jpnich/Group-Project-Y2/Interface/Final Circuits.pptx

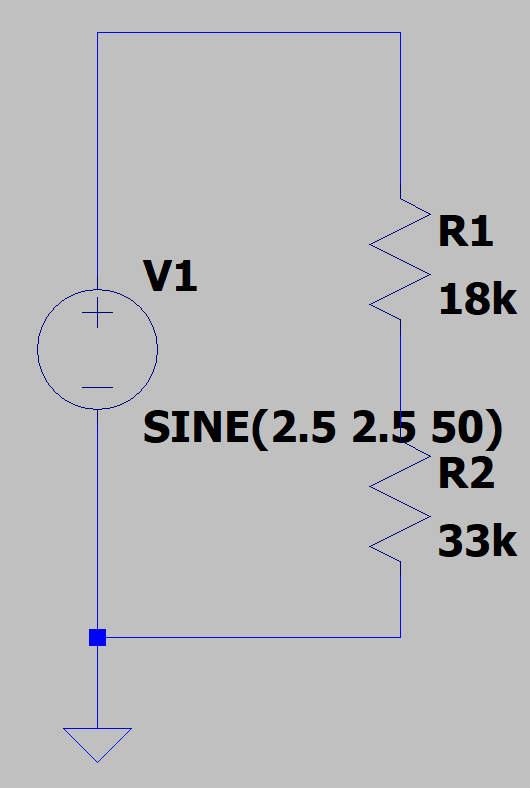
[picture p9: figure]

(a)

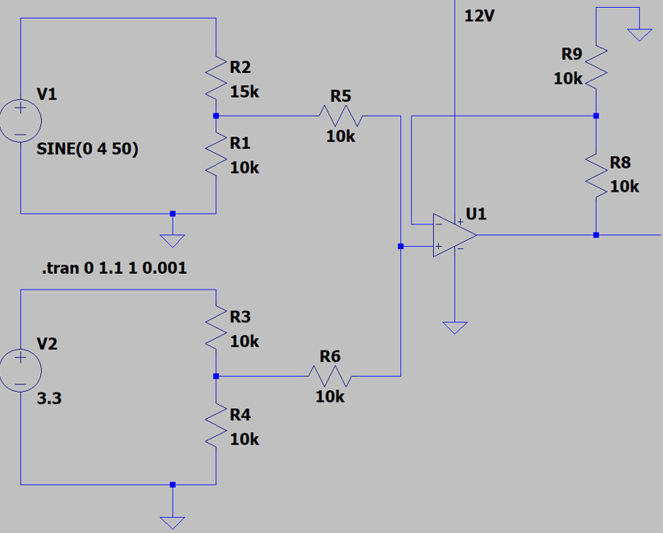
[picture p10: figure]
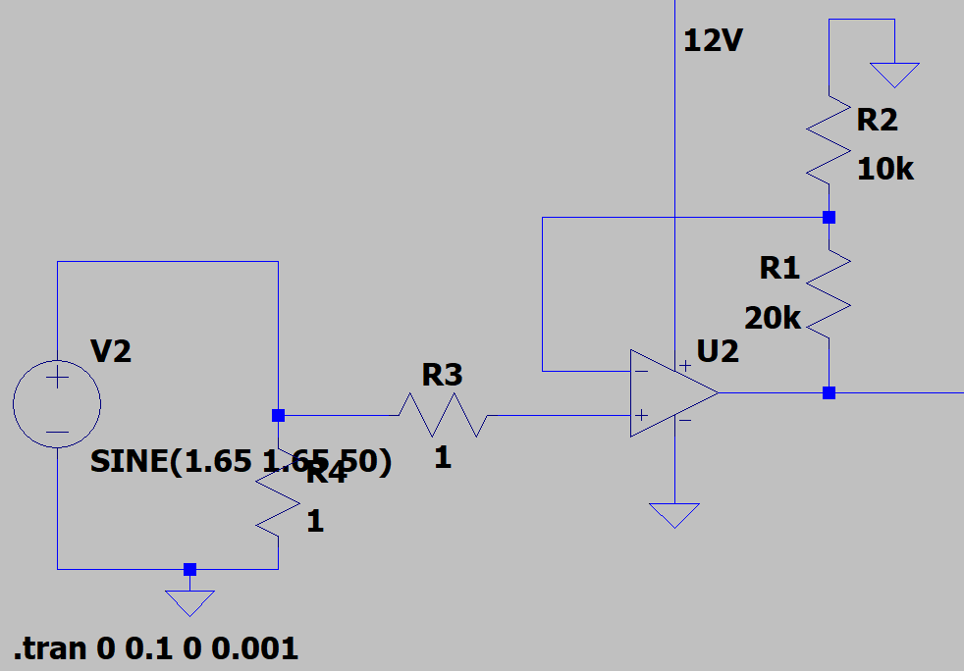
[picture p11: figure]

(c)

(e)

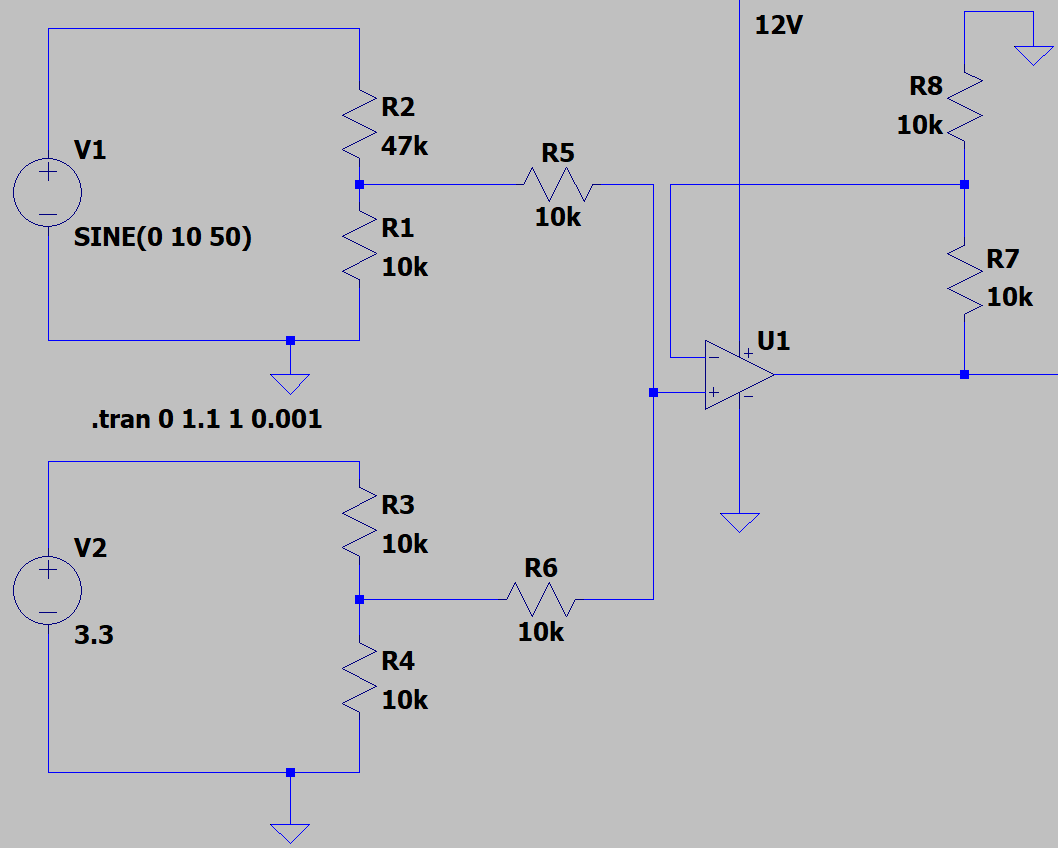
[picture p12: figure]

(b)

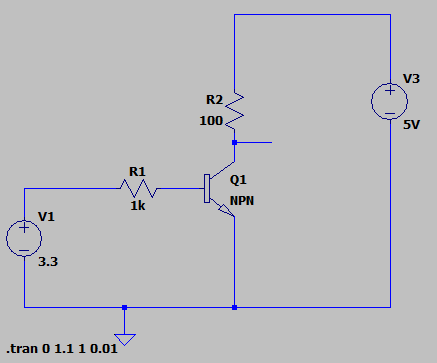
[picture p13: figure]

(d)

(a) Busbar voltage
(b) usbar current
(c) mains capacity
(d) digital inputs
(e) digital outputs
