jpnich/Group-Project-Y2/Interface/drawn_circuitry.pptx

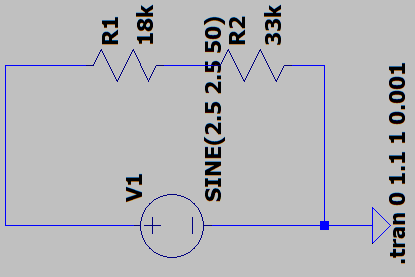
[picture p14: figure]
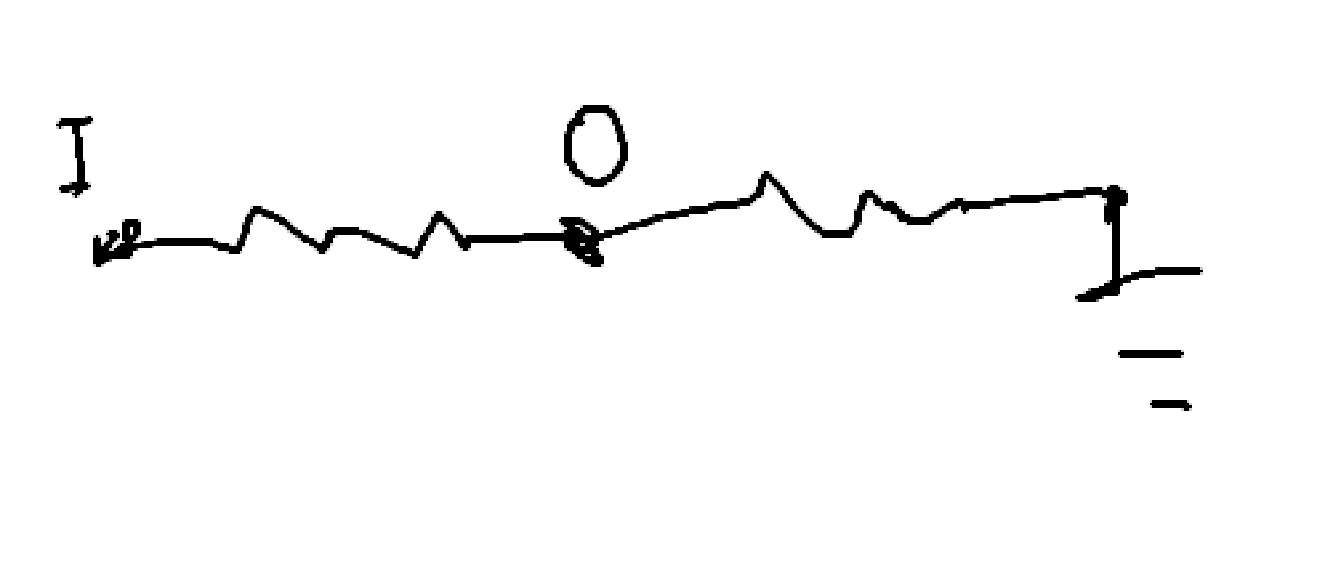
[picture p15: figure]

## Slide 2

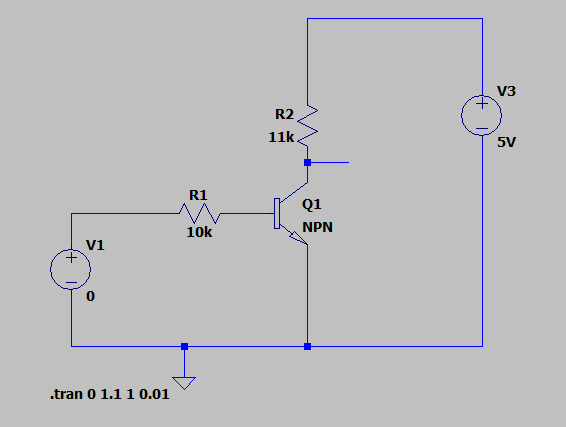
[picture p16: figure]
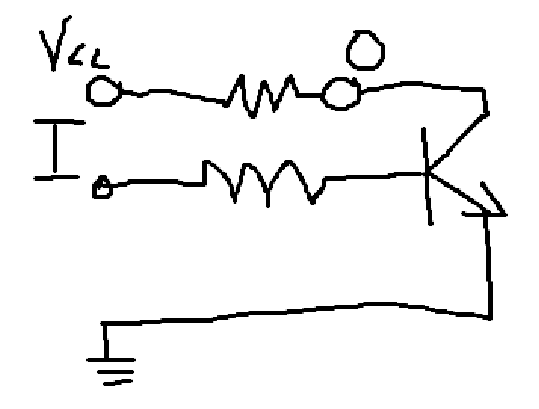
[picture p17: figure]

## Slide 3

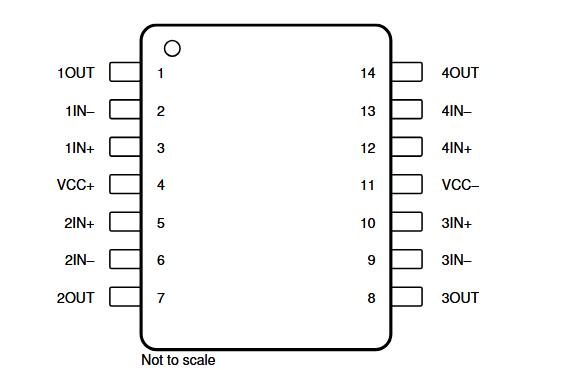
[picture p18: figure]
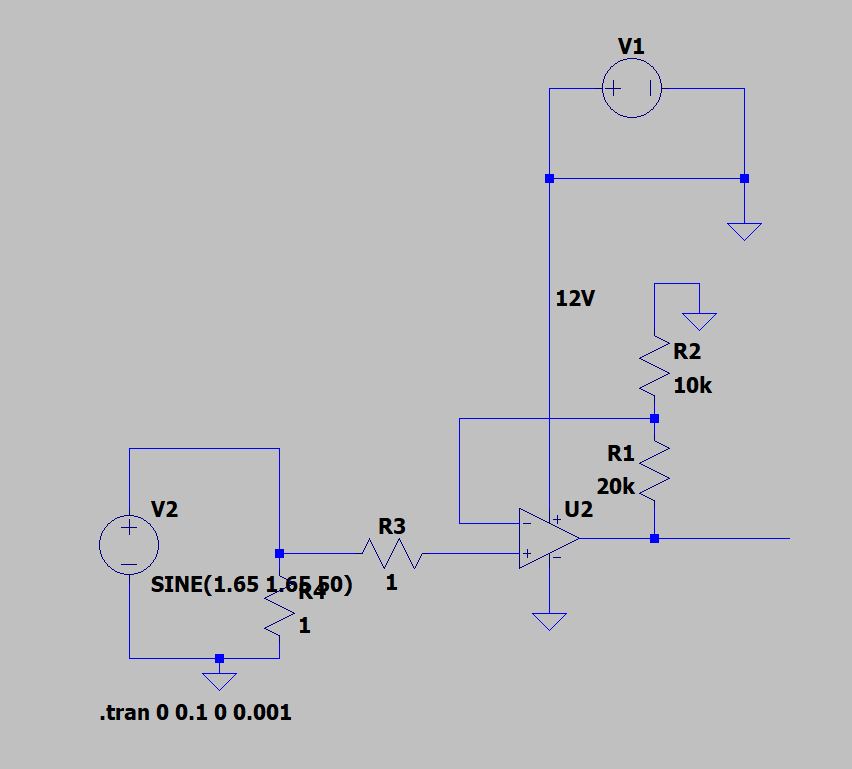
[picture p19: figure]
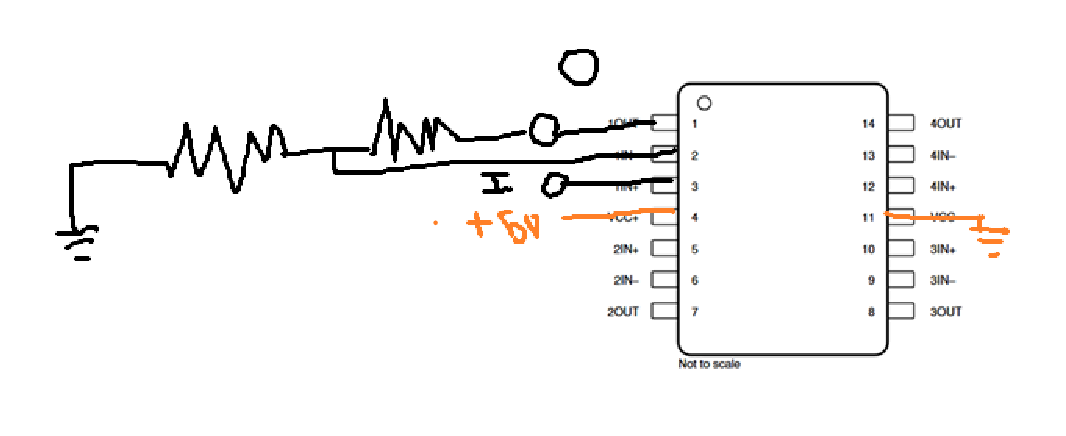
[picture p20: figure]

## Slide 4

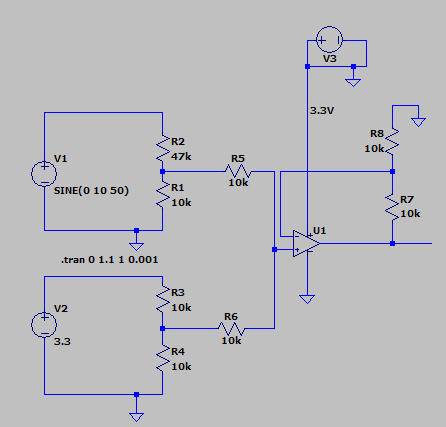
[picture p21: figure]
