jpnich/Group-Project-Y2/Purchase Log.xlsx

Sheet: Requisition
 |  |  |  |  |  |  |  | Form completed by:
 |  |  |  |  |  |  |  |  | Group:
 |  |  |  |  |  |  |  |  | Contact name:
 |  |  |  |  |  |  |  |  | Contact email:
 |  |  |  |  |  |  |  | Supplier (see list on other sheet): |  | multiple
 |  |  |  |  |  |  |  | Total spend before this requisition (£): |  | £0.00
Line | Quantity | Supplier Stock Code | Description | URL | Unit Price £ (ex VAT) | Total Price £ (ex VAT) | In Stock? [Y/N]
1 | 1 | CN22076 | 5mm PCB terminal block, 2 way | https://onecall.farnell.com/multicomp-pro/mc000026/terminal-block-wire-to-brd-2pos/dp/CN22076 | £0.90 | £0.90 | Y
2 | 1 | 1903794 | 150Ω 2W resistor | https://onecall.farnell.com/multicomp-pro/mcknp02sj0151a10/res-150r-5-2w-axial-wirewound/dp/1903794 | £0.16 | £0.16 | Y
3 | 1 | 2917944 | 1000uF 35V electrolytic capacitor | https://uk.farnell.com/panasonic/eeufs1v102lb/cap-1000uf-35v-alu-elec-radial/dp/2917944 | £1.09 | £1.09 | Y
4 | 1 | 09 2782 | Hahn BV El 306 3365 PCB Mount Transformer 230V AC to 12V AC 3.0VA | https://www.rapidonline.com/hahn-bv-ei-306-3365-pcb-mount-transformer-230v-to-12v-ac-3-0va-09-2782?incVat=1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 | £4.79 | £4.79 | Y
5 | 1 | MC000026 | 5mm PCB Terminal Block, 2 Way, 26AWG to 12AWG, Screw | https://onecall.farnell.com/multicomp-pro/mc000026/terminal-block-wire-to-brd-2pos/dp/CN22076 | 0.9 | 1.08 | Y
6 | 1 | M20-9990246 | M20-999 series from Harwin are 2.54mm pitch, single row SIL vertical PC tail pin headers. | https://onecall.farnell.com/harwin/m20-9990246/0-1-pin-header-2-way/dp/CN01043 | 0.4 | 0.48 | Y
7 | 1 | B32923C3105M000 | Safety Capacitor, Metallized PP, Radial Box - 2 Pin, 1 µF, ± 20%, X2, Through Hole | https://onecall.farnell.com/epcos/b32923c3105m000/cap-1-f-20-pp/dp/1781894 | 0.5 | 0.6 | Y
8 | 2 | PR02000203303JA100 | Through Hole Resistor, 330 kohm, PR02 Series, 2 W, ± 5%, Axial Leaded, 500 V | https://onecall.farnell.com/vishay/pr02000203303ja100/res-330k-2w-500v-axial-metal-film/dp/4844651 | 0.3 | 0.36 | Y
 | 1 | 1N4744A,113 | Zener Single Diode, 15 V, 1 W, DO-41 (DO-204AL), 2 Pins, 200 °C, Through Hole | https://onecall.farnell.com/nexperia/1n4744a-113/diode-zener-15v-1w-sod66/dp/2114877 | 1.2 | 1.44 | Y
9 | 1 | PR02000202709JA100 | Through Hole Resistor, 27 ohm, PR02 Series, 2 W, ± 5%, Axial Leaded, 500 V | https://onecall.farnell.com/vishay/pr02000202709ja100/res-27r-2w-500v-axial-metal-film/dp/4844643 | 0.3 | 0.36 | Y
10 | 1 | MCRH25V337M10X13 | Electrolytic Capacitor, 330 µF, 25 V, ± 20%, Radial Leaded, 2000 hours @ 105°C, Polar | https://onecall.farnell.com/multicomp-pro/mcrh25v337m10x13/cap-330-f-25v-20/dp/9451854 | 0.41 | 0.5 | Y
11 | 1 | 9452036 | MCRH63V106M5X11 Electrolytic Capacitor, 10 µF, 63 V, ± 20%, Radial Leaded, 2000 hours @ 105°C, Polar | https://onecall.farnell.com/multicomp-pro/mcrh63v106m5x11/cap-10-f-63v-20/dp/9452036 | £0.09 | £0.09 | Y | Jeremy
12 | 1 | 1831286 | 25ZLK470M8X20 Electrolytic Capacitor, Miniature, 470 µF, 25 V, ± 20%, Radial Leaded, 4000 hours @ 105°C, Polar | https://onecall.farnell.com/rubycon/25zlk470m8x20/cap-470-f-25v-20/dp/1831286 | £0.39 | £0.39 | Y
13 | 2 | 2901306 | TS170R1H104MSBFB0R Multilayer Ceramic Capacitor, 0.1 µF, 50 V, ± 20%, PC Pin, Y5V, 5.08 mm | https://onecall.farnell.com/suntan/ts170r1h104msbfb0r/cap-0-1-f-50v-20-y5v/dp/2901306 | £0.14 | £0.28 | Y
14 | 1 | 1689075 | 44195 PCB Transformer, EI 38 x 13.6, Encapsulated Safety Isolating, 230V, 12V, 3.2 VA, 50Hz / 60Hz | https://onecall.farnell.com/myrra/44195/transformer-3-2va-12v/dp/1689075 | £3.56 | £3.56 | Y
15 | 1 | AC03000004709JAC00 | Through Hole Resistor, 47 ohm, AC Series, 3 W, ± 5%, Axial Leaded | https://onecall.farnell.com/vishay/ac03000004709jac00/res-47r-5-3w-axial-wirewound/dp/1735089 | £0.71 | £0.71 | Y
16 | 1 | PR03000204703JAC00 | Through Hole Resistor, 470 kohm, PR03 Series, 3 W, ± 5%, Axial Leaded, 750 V | https://onecall.farnell.com/vishay/pr03000204703jac00/res-470k-5-3w-axial-metal-film/dp/2614563 | £0.50 | £0.50 | Y
17 | 1 | MCPKNPA1WJ0200A10 | Through Hole Resistor, 20 ohm, MC KNPA Series, 1 W, ± 5%, Axial Leaded, 500 V | https://onecall.farnell.com/multicomp-pro/mcpknpa1wj0200a10/resistor-20r-5-1w-axial/dp/4227304 | £0.10 | £0.10 | Y
18 | 5 | 1N5927BG | Zener Single Diode, Surmetic, 12 V, 3 W, DO-41 (DO-204AL), 5 %, 2 Pins, 200 °C | https://uk.farnell.com/on-semiconductor/1n5927bg/zener-diode-12v-axial/dp/2535673 | £0.30 | £1.49 | Y
19 | 1 | EEUHD1E102 | Electrolytic Capacitor, 1000 µF, 25 V, ± 20%, Radial Leaded, 2000 hours @ 105°C, Polar | https://onecall.farnell.com/panasonic/eeuhd1e102/cap-1000-f-25v-20/dp/1973481 | £1.20 | £1.20 | Y
20 | 1 | B32923C3155M000 | Safety Capacitor, Metallized PP, Radial Box - 2 Pin, 1.5 µF, ± 20%, X2, Through Hole | https://onecall.farnell.com/epcos/b32923c3155m000/cap-1-5-f-20-pp/dp/1781895 | £1.01 | £1.01 | Y
 |  |  | Total requisition value (ex VAT): |  |  | £21.09
 |  |  | Total requisition value (inc VAT): |  |  | £25.31
 |  |  | Total spend after this requisition: |  |  | £25.31
 |  |  |  |  | £ (Ex) VAT | £(INC) VAT

Sheet: Suppliers
 |  | Unofficial Suppliers
Supplier | URL | Supplier | URL
Acorn Industrial | Acorn Industrial Services | Industrial Supplies | Buy Online (https://www.acorn-ind.co.uk/) | MFA/Como Drills | MFA Home Page (https://www.mfacomo.com/)
Digi-Key | DigiKey United Kingdom | Electronic Parts and Components – Fast Shipping, Global Support (https://www.digikey.co.uk/) | Model Shop Leeds | Model Shop Leeds (https://www.modelshopleeds.co.uk/catalog/index.php)
Maplin Pro | Maplin Pro | Your One Stop Component Shop (https://pro.maplin.co.uk/) | Pimoroni | The ultimate Maker store - Pimoroni (https://shop.pimoroni.com/)
Mouser | Electronic Components Distributor - Mouser Electronics United Kingdom (https://www.mouser.co.uk/) | The Pi Hut | The Ultimate Raspberry Pi & Maker Store (https://thepihut.com/)
Onecall (Farnell) | Farnell® UK - Electronic Components Distributor (https://onecall.farnell.com/)
Rapid Electronics | https://www.rapidonline.com/
RobotShop | RobotShop | Robot Store | Robots | Robot Parts | Robot Kits | Robot Toys (https://uk.robotshop.com/)
RS Components | Industrial Solutions & Electrical Components | RS (https://uk.rs-online.com/web/)
Rubix | RUBIX UK | Industrial supply (https://uk.rubix.com/en)
