jpnich/Group-Project-Y2/PSU/CapacitorDropper1.asc

C1: cap; 10µF
C2: cap; 1000µF
CX1: cap; 1µF
D1: diode; BZX84C12L
D2: diode
D3: diode
D4: diode
D5: diode
D6: diode
MAINS: voltage; SINE(0 375 50)
R1: res; 2
R2: res; 330k
R3: res; 2
R4: res; 100
Named nets: 0
.tran 0 50m 0 1u
