jpnich/Group-Project-Y2/PSU/CapacitorDropper2.asc

C1: cap; 0.1µF
C2: cap; 0.1µF
C3: cap; 100µF
CX1: cap; 10µF
D1: diode; 1N4007
D2: diode; 1N4007
D3: diode; 1N4007
D4: diode; 1N4007
D5: diode; 1N4007
D6: diode; 1N4007
LOAD: res; 100
MAINS: voltage; SINE(0 375 50)
R1: res; 300
R2: res; 330k
U1: LT1086-12
Named nets: 0
.tran 0 10 1 100u
