jpnich/Group-Project-Y2/PSU/ChargePump1.asc

C1: cap; 220n
C2: cap; 470µ
D1: diode; MUR460
D2: diode; MUR460
D3: diode; BZX84C10L
R1: res; 300
R2: res; 47
R3: res; 5k
V1: voltage; SINE(0 340 50)
Named nets: 0
.tran 0 1.1 1.0 0.0001
