jpnich/Group-Project-Y2/PSU/ChargePump2.asc

C2: cap; 10µF
CX1: cap; 100µF
D1: diode; 1N4007
D2: diode; 1N4007
D3: diode; BZX84C12L
LOAD: res; 144
MAINS: voltage; SINE(0 375 50)
R1: res; 300
R2: res; 4k
U1: LT1086-12
Named nets: 0
.tran 0 10 1 10000u
