jpnich/Group-Project-Y2/PSU/Draft1.asc

C1: cap
D1: diode
D2: diode
D3: diode
D4: diode
Lp: ind
Ls: ind
MAINS: voltage; SINE(0 325 50)
R1: res
R2: res
K Lp Ls 1
