jpnich/Group-Project-Y2/PSU/Draft2.asc

C1: cap; 0.1µF
C2: cap; 10µF
C3: cap; 0.1µF
C4: cap; 10µF
C5: cap; 0.1µF
C6: cap; 10µF
C7: cap; 0.1µF
C8: cap; 10µF
D1: diode; 1N4007
D2: diode; 1N4007
D3: diode; 1N4007
D4: diode; 1N4007
R1: res; 100
R2: res; 100
U1: LT1086-5
U2: LT1086-3.3
V1: voltage; 12V
Named nets: 0
.tran 0 1.1 1 0.05
