jpnich/Group-Project-Y2/PSU/Draft3.asc

Q1: npn3
R1: res; 1000
R2: res; 100
V1: voltage; 3.3
V2: voltage; 5
Named nets: 0
