jpnich/Group-Project-Y2/PSU/Draft4.asc

R1: res; 10k
R2: res; 15k
R3: res; 10k
R4: res; 10k
R5: res; 10k
R6: res; 10k
R7: res; 1
U1: opamp
V1: voltage; SINE(0 4 50)
V2: voltage; 3.3
Named nets: 0
.tran 0 1.1 1 0.001
.lib opamp.sub
