jpnich/Group-Project-Y2/PSU/Draft5.asc

C1: cap; 10µF
C2: cap; 1000µF
D1: diode; 1N4007
D2: diode; 1N4007
LOAD: res; 144
MAINS: voltage; SINE(0 375 50)
R1: res; 470k
U1: LT1086-12
Named nets: 0
