jpnich/Group-Project-Y2/PSU/Draft6.asc

R1: res; 10k
R2: res; 15k
R3: res; 10k
R4: res; 10k
R5: res; 10k
R6: res; 10k
R7: res; 10k
R8: res; 10k
U1: UniversalOpAmp1
V1: voltage; SINE(0 4 50)
V2: voltage; 3.3
V3: voltage; 3.3V
Named nets: 0
.tran 0 1.1 1 0.001
