jpnich/Group-Project-Y2/PSU/TransformerPSU1.asc

C1: cap; 1000µF
C2: cap; 4000µF
C3: cap; 1000µF
C4: cap; 4000µF
C5: cap; 0.1µF
C6: cap; 0.1µF
C7: cap; 0.1µF
C8: cap; 0.1µF
C9: cap; 10µF
C10: cap; 10µF
D1: diode; 1N4007
D2: diode; 1N4007
D3: diode; 1N4007
D4: diode; 1N4007
D5: diode; 1N4007
D6: diode; 1N4007
LOAD1: res; 144
LOAD2: res; 144
Lp: ind; 10H
Ls: ind; 27.2mH
MAINS: voltage; SINE(0 375 50)
R1: res; 1R
R2: res; 20R
R5: res; 1mR
U1: LT1086-12
U2: LT1086-12
Named nets: 0
K Lp Ls 1
.tran 0 1.1 1.0 0.0001
