jpnich/Group-Project-Y2/PSU/TransformerPSU2.asc

C1: cap; 0.1µF
C1_pol: cap; 470µF
C2: cap; 0.1µF
C2_pol: cap; 10µF
D1: diode; 1N4007
D2: diode; 1N4007
D3: diode; 1N4007
D4: diode; 1N4007
D5: diode; 1N4007
D6: diode; 1N4007
LOAD1: res; 144
Lp: ind; 1H
Ls: ind; 2.72mH
MAINS: voltage; SINE(0 375 50)
R5: res; 1m
U1: LT1086-12
Named nets: 0
K Lp Ls 1
.tran 0 1.1 1.0 0.0001
