jpnich/Group-Project-Y2/Interface/3.3_to_5v_logic.asc

Q1: npn3
R1: res; 5k
R2: res; 10k
R3: res; 1
R4: res; 1
V1: voltage; 0
V3: voltage; 5V
Named nets: 0
.tran 0 1.1 1 0.01
