jpnich/Group-Project-Y2/Interface/5_to_3.3v_logic.asc

R1: res; 18k
R2: res; 33k
V1: voltage; SINE(2.5 2.5 50)
Named nets: 0
.tran 0 1.1 1 0.001
