jpnich/Group-Project-Y2/Interface/Draft1.asc

R1: res; 20k
R2: res; 10k
U1: UniversalOpAmp
V1: voltage; 12V
V2: voltage; 3.3v
Named nets: 0
.tran 0 1.1 1 0.001
