jpnich/Group-Project-Y2/Interface/mains_capacity.asc

R1: res; 20k
R2: res; 10k
R3: res; 1
R4: res; 1
U2: UniversalOpAmp1
V1: voltage; 12V
V2: voltage; SINE(1.65 1.65 50)
Named nets: 0
.tran 0 0.1 0 0.001
