jpnich/Group-Project-Y2/Interface/Simulations/Draft1.asc

C1: cap; 1µF
PWM: voltage; PULSE(0 3.3 0 1u 1u 300u 1m)
R1: res; 10k
R2: res; 1k
R3: res; 2k
R4: res; 1000
U1: opamp
Named nets: 0
.tran 0 1 0.1 100u
.lib opamp.sub
