jpnich/Group-Project-Y2/(commit log)

2026-11-04 Added signal conditioning circuitry
2026-11-04 Added PCB files for PSU
    [PSU-B_Cu.gbr, PSU-B_Mask.gbr, PSU-B_Paste.gbr, PSU-B_Silkscreen.gbr, PSU-Edge_Cuts.gbr, PSU-F_Cu.gbr, PSU-F_Mask.gbr, PSU-F_Paste.gbr]
2026-11-04 Added Gantt Chart & Purchase Log
    [Project Gantt Chart.xlsx, Purchase Log.xlsx]
